StudentOrganisationForAerospaceResearch/Andromeda-V2.2/AndromedaV2.2.kicad_pcb

## KiCad design AndromedaV2.2.kicad_pcb (2019-05-11)

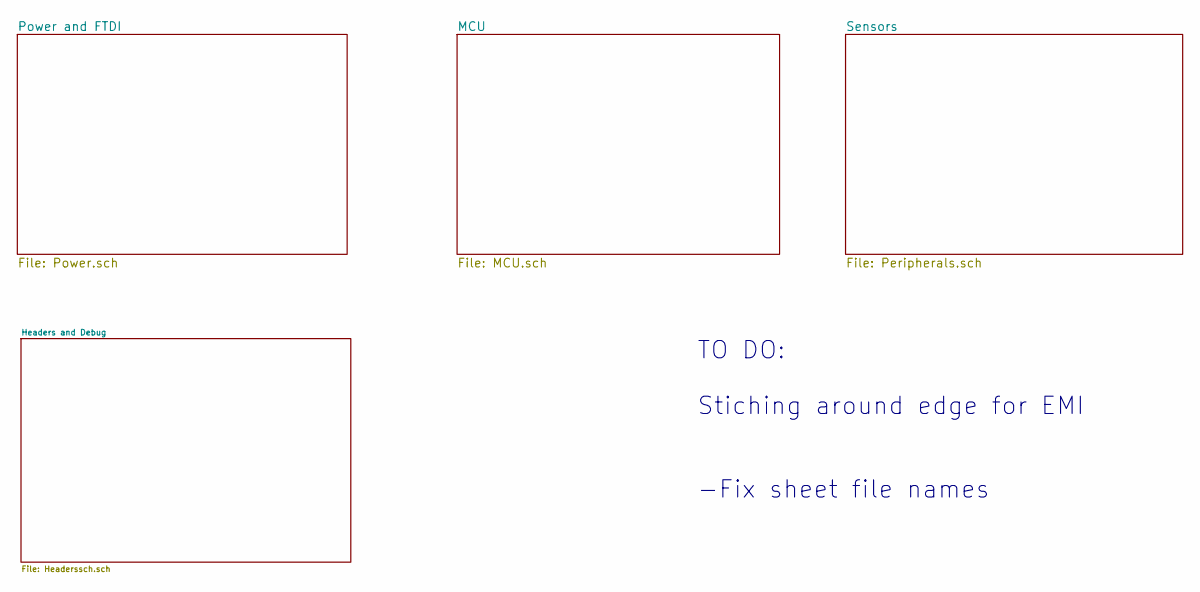
[picture p6: schematic AndromedaV2.2.sch, SOAR Avionics Sensor Board]

Notes on the sheet:
TO DO: Stiching around edge for EMI -Fix sheet file names

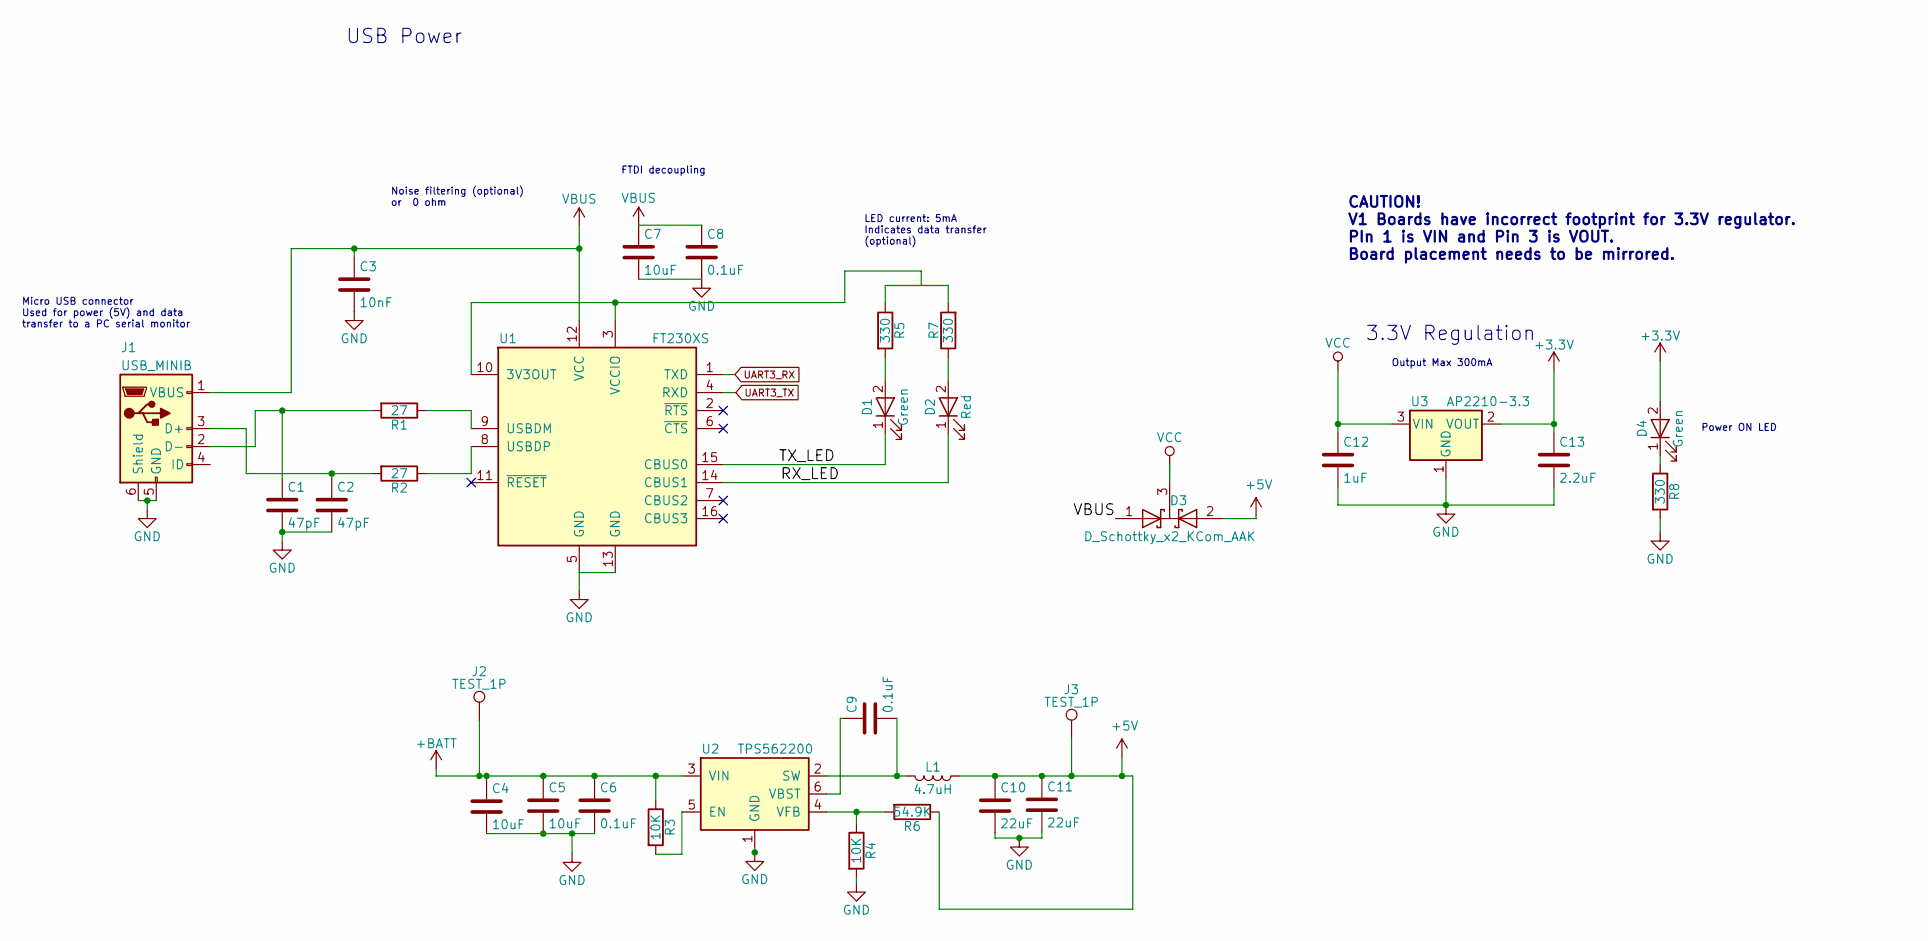
[picture p7: schematic Power.sch, SOAR Avionics Sensor Board]

Parts:
C1, C2: 47pF; C_0603
C3: 10nF; C_0603
C4, C5, C7: 10uF; C_0603
C6, C8, C9: 0.1uF; C_0603
C10, C11: 22uF; C_0603
C12: 1uF; C_0603
C13: 2.2uF; C_0603
D1, D4: Green; LED_0805_2012Metric; Digikey LG R971-KN-1
D2: Red; LED_0805_2012Metric; Digikey 475-1278-1-ND
D3: D_Schottky_x2_KCom_AAK; SOT-23; Digikey 1727-5188-1-ND
J1: USB_MINIB; USB-Mini-B; Digikey 690-005-299-043
J2, J3: TEST_1P; Test_Point_Pad_d1.5mm
L1: 4.7uH; L_1008
R1, R2: 27; R_0603
R3, R4: 10K; R_0603
R5, R7, R8: 330; R_0603
R6: 54.9K; R_0603
U1: FT230XS; SSOP-16_3.9x4.9mm_P0.635mm; Digikey 768-1135-1-ND
U2: TPS562200; SOT-23-6
U3: AP2210-3.3; SOT-23

Connections:
+3V3: C13.1, D4.2 (A), U3.2 (VOUT); also elsewhere on the board
+5V: C10.1, C11.1, D3.2 (A), J3.1, L1.1, R6.1; also elsewhere on the board
+BATT: C4.1, C5.1, C6.1, J2.1, R3.1, U2.3 (VIN); also elsewhere on the board
/Power and FTDI/RX_LED: D2.1 (K), U1.14 (CBUS1)
/Power and FTDI/TX_LED: D1.1 (K), U1.15 (CBUS0)
GND: C1.2, C2.2, C3.2, C4.2, C5.2, C6.2, C7.2, C8.2, C10.2, C11.2, C12.2, C13.2, J1.5 (GND), J1.6 (Shield), R4.2, R8.2, U1.5 (GND), U1.13 (GND), U2.1 (GND), U3.1 (GND); also elsewhere on the board
unnamed: C1.1, J1.2 (D-), R1.2
unnamed: C2.1, J1.3 (D+), R2.2
unnamed: C9.1, U2.6 (VBST)
unnamed: C9.2, L1.2, U2.2 (SW)
unnamed: D1.2 (A), R5.2
unnamed: D2.2 (A), R7.1
unnamed: D4.1 (K), R8.1
unnamed: R1.1, U1.9 (USBDM)
unnamed: R2.1, U1.8 (USBDP)
unnamed: R3.2, U2.5 (EN)
unnamed: R4.1, R6.2, U2.4 (VFB)
unnamed: R5.1, R7.2
unnamed: U1.3 (VCCIO), U1.10 (3V3OUT)
UART3_RX: U1.1 (TXD); also elsewhere on the board
UART3_TX: U1.4 (RXD); also elsewhere on the board
VBUS: C3.1, C7.1, C8.1, D3.1 (A), J1.1 (VBUS), U1.12 (VCC)
VCC: C12.1, D3.3 (K), U3.3 (VIN)

Notes on the sheet:
Output Max 300mA
Power ON LED
LED current: 5mA Indicates data transfer (optional)
Micro USB connector Used for power (5V) and data transfer to a PC serial monitor
Noise filtering (optional) or 0 ohm
FTDI decoupling
USB Power
3.3V Regulation
CAUTION! V1 Boards have incorrect footprint for 3.3V regulator. PIn 1 is VIN and Pin 3 is VOUT. Board placement needs to be mirrored.

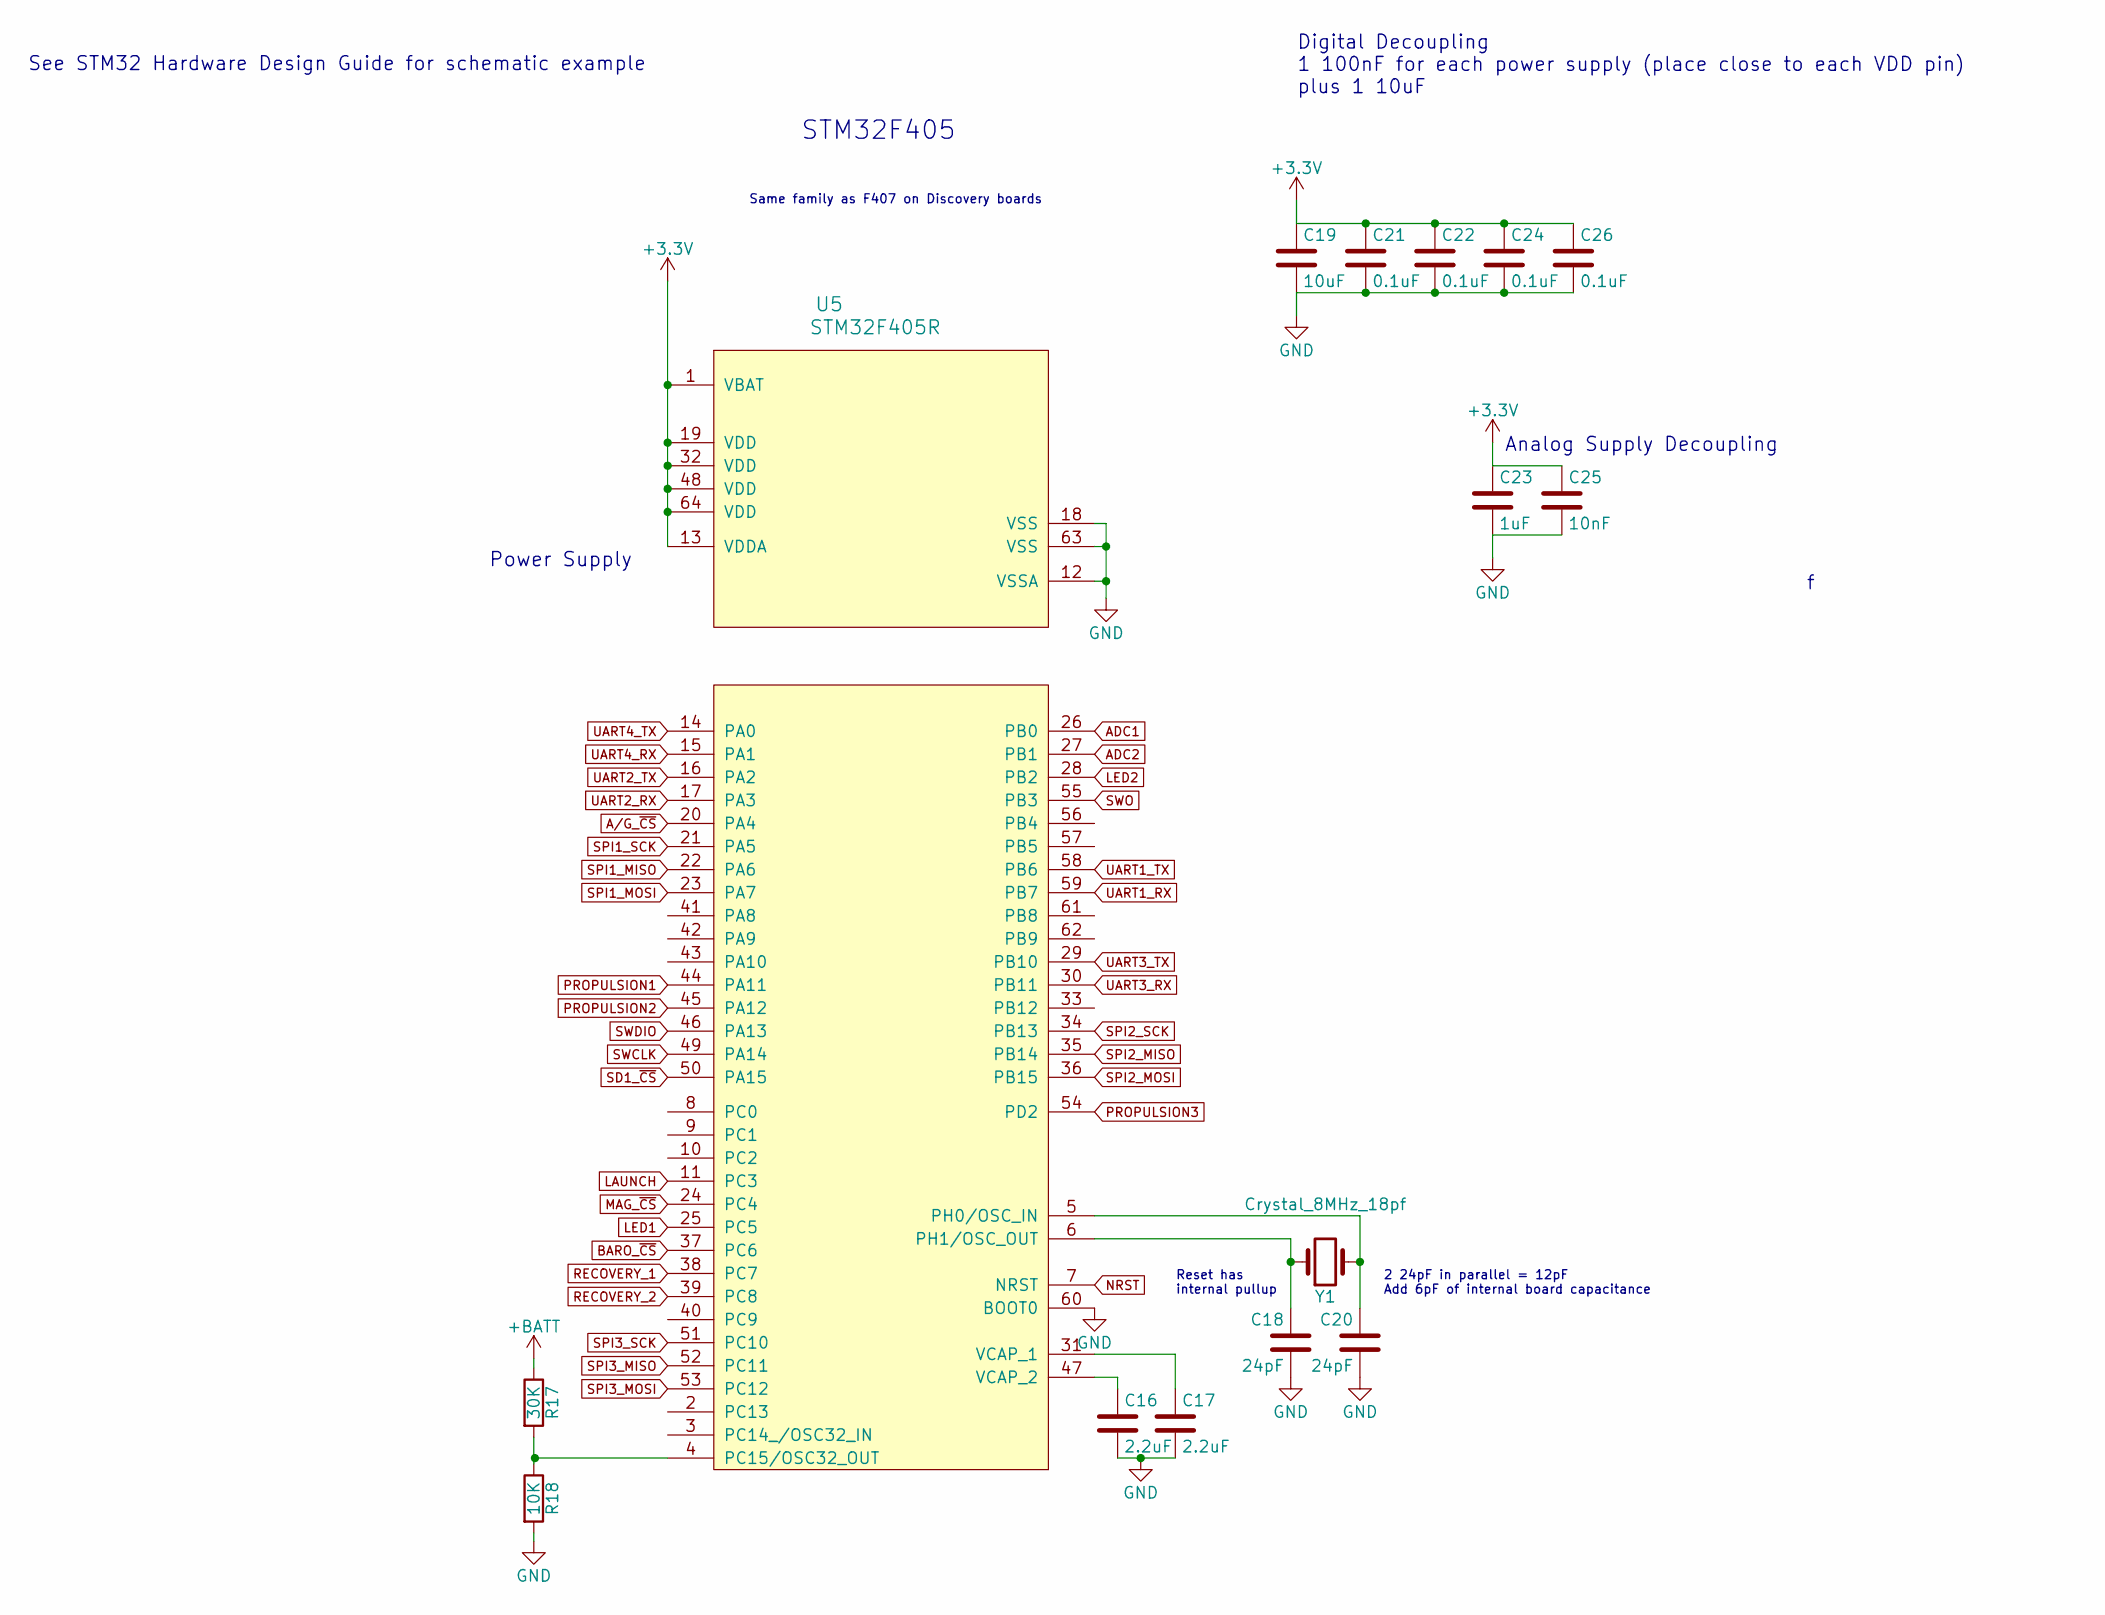
[picture p8: schematic MCU.sch, SOAR Avionics Sensor Board]

Parts:
C16, C17: 2.2uF; C_0603
C18, C20: 24pF; C_0603
C19: 10uF; C_0603
C21, C22, C24, C26: 0.1uF; C_0603
C23: 1uF; C_0603
C25: 10nF; C_0603
R17: 30K; R_0603
R18: 10K; R_0603
U5: STM32F405R; LQFP-64_10x10mm_P0.5mm; Digikey 497-11767-ND
Y1: Crystal_8MHz_18pf; Crystal_SMD_HC49-SD; Digikey 535-9089-1-ND

Connections:
+3V3: C19.1, C21.1, C22.1, C23.1, C24.1, C25.1, C26.1, U5.1 (VBAT), U5.13 (VDDA), U5.19 (VDD), U5.32 (VDD), U5.48 (VDD), U5.64 (VDD); also elsewhere on the board
+BATT: R17.1; also elsewhere on the board
A/G_~CS: U5.20 (PA4); also elsewhere on the board
ADC1: U5.26 (PB0); also elsewhere on the board
ADC2: U5.27 (PB1); also elsewhere on the board
BARO_~CS: U5.37 (PC6); also elsewhere on the board
GND: C16.2, C17.2, C18.2, C19.2, C20.2, C21.2, C22.2, C23.2, C24.2, C25.2, C26.2, R18.2, U5.12 (VSSA), U5.18 (VSS), U5.60 (BOOT0), U5.63 (VSS); also elsewhere on the board
LAUNCH: U5.11 (PC3); also elsewhere on the board
LED1: U5.25 (PC5); also elsewhere on the board
LED2: U5.28 (PB2); also elsewhere on the board
MAG_~CS: U5.24 (PC4); also elsewhere on the board
NRST: U5.7 (NRST); also elsewhere on the board
unnamed: C16.1, U5.47 (VCAP_2)
unnamed: C17.1, U5.31 (VCAP_1)
unnamed: C18.1, U5.6 (PH1/OSC_OUT), Y1.1
unnamed: C20.1, U5.5 (PH0/OSC_IN), Y1.2
unnamed: R17.2, R18.1, U5.4 (PC15/OSC32_OUT)
PROPULSION1: U5.44 (PA11); also elsewhere on the board
PROPULSION2: U5.45 (PA12); also elsewhere on the board
PROPULSION3: U5.54 (PD2); also elsewhere on the board
RECOVERY_1: U5.38 (PC7); also elsewhere on the board
RECOVERY_2: U5.39 (PC8); also elsewhere on the board
SD1_~CS: U5.50 (PA15); also elsewhere on the board
SPI1_MISO: U5.22 (PA6); also elsewhere on the board
SPI1_MOSI: U5.23 (PA7); also elsewhere on the board
SPI1_SCK: U5.21 (PA5); also elsewhere on the board
SPI2_MISO: U5.35 (PB14); also elsewhere on the board
SPI2_MOSI: U5.36 (PB15); also elsewhere on the board
SPI2_SCK: U5.34 (PB13); also elsewhere on the board
SPI3_MISO: U5.52 (PC11); also elsewhere on the board
SPI3_MOSI: U5.53 (PC12); also elsewhere on the board
SPI3_SCK: U5.51 (PC10); also elsewhere on the board
SWCLK: U5.49 (PA14); also elsewhere on the board
SWDIO: U5.46 (PA13); also elsewhere on the board
SWO: U5.55 (PB3); also elsewhere on the board
UART1_RX: U5.59 (PB7); also elsewhere on the board
UART1_TX: U5.58 (PB6); also elsewhere on the board
UART2_RX: U5.17 (PA3); also elsewhere on the board
UART2_TX: U5.16 (PA2); also elsewhere on the board
UART3_RX: U5.30 (PB11); also elsewhere on the board
UART3_TX: U5.29 (PB10); also elsewhere on the board
UART4_RX: U5.15 (PA1); also elsewhere on the board
UART4_TX: U5.14 (PA0); also elsewhere on the board

Notes on the sheet:
Reset has internal pullup
Digital Decoupling 1 100nF for each power supply (place close to each VDD pin) plus 1 10uF
Analog Supply Decoupling
See STM32 Hardware Design Guide for schematic example
Power Supply
2 24pF in parallel = 12pF Add 6pF of internal board capacitance
STM32F405
Same family as F407 on Discovery boards

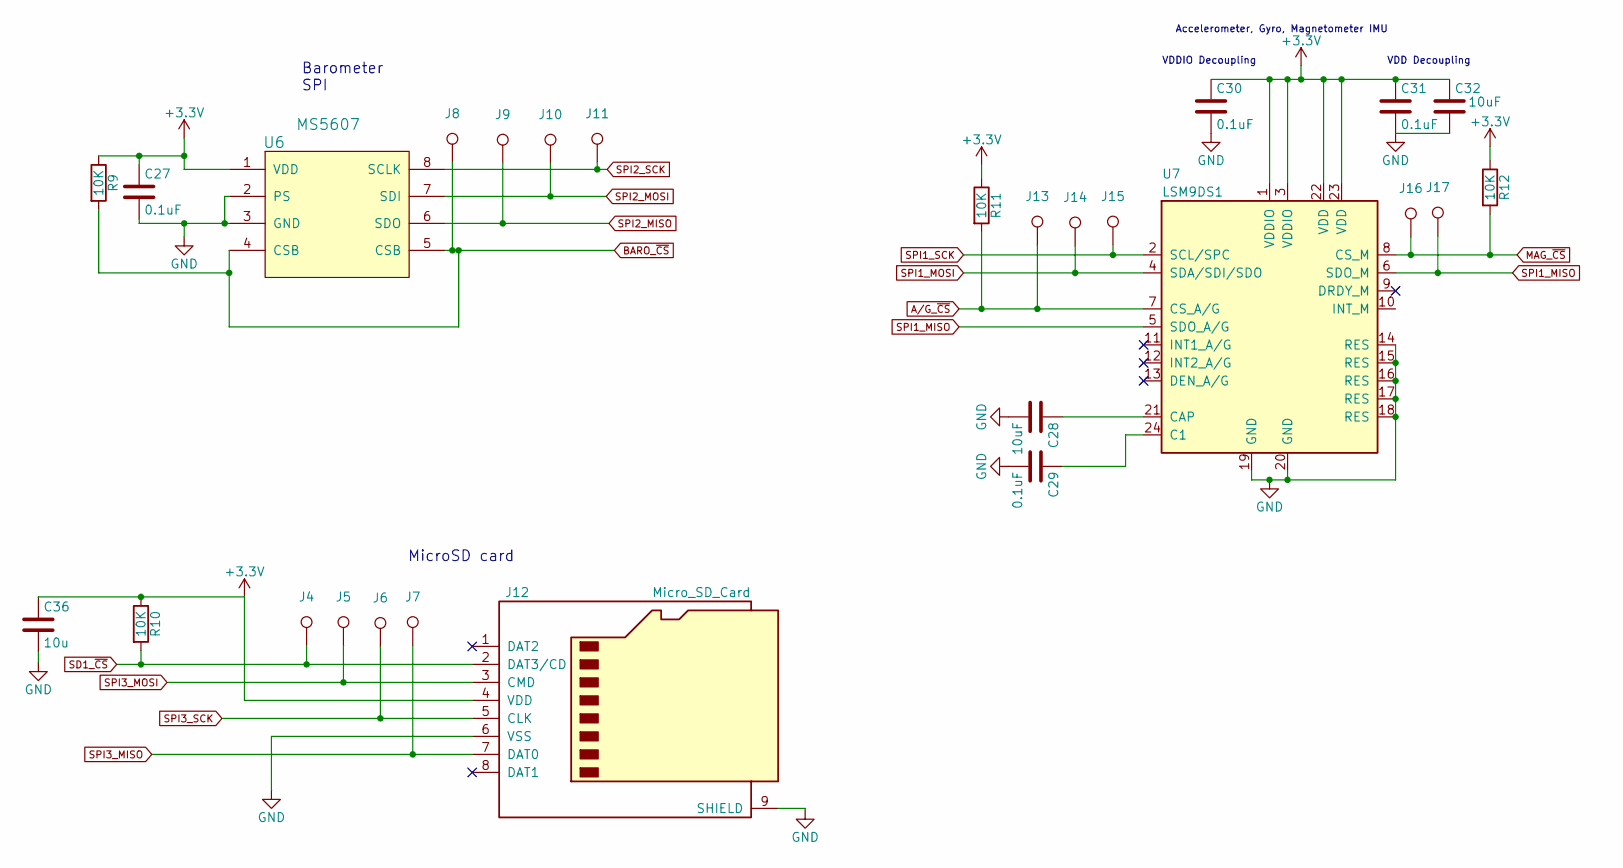
[picture p9: schematic Peripherals.sch, SOAR Avionics Sensor Board]

Parts:
C27, C29, C30, C31: 0.1uF; C_0603
C28, C32: 10uF; C_0603
C36: 10u; C_0603
J4, J5, J6, J7, J8, J9, J10, J11, J13, J14, J15, J16, J17: TEST_1P; Test_Point_Pad_d1.5mm
J12: Micro_SD_Card; Hirose_DM3AT-SF-PEJM5_MicroSD; Digikey 0472192001
R9, R10, R11, R12: 10K; R_0603
U6: MS5607; LGA-8_3x5mm_P1.25mm; Digikey MS560702BA03-00
U7: LSM9DS1; LGA-24L_3x3.5mm_P0.43mm; Digikey 497-14946-1-ND

Connections:
+3V3: C27.1, C30.1, C31.1, C32.1, C36.1, J12.4 (VDD), R9.1, R10.1, R11.1, R12.1, U6.1 (VDD), U7.1 (VDDIO), U7.3 (VDDIO), U7.22 (VDD), U7.23 (VDD); also elsewhere on the board
A/G_~CS: J13.1, R11.2, U7.7 (CS_A/G); also elsewhere on the board
BARO_~CS: J8.1, R9.2, U6.4 (CSB), U6.5 (CSB); also elsewhere on the board
GND: C27.2, C28.2, C29.2, C30.2, C31.2, C32.2, C36.2, J12.6 (VSS), J12.9 (SHIELD), U6.2 (PS), U6.3 (GND), U7.14 (RES), U7.15 (RES), U7.16 (RES), U7.17 (RES), U7.18 (RES), U7.19 (GND), U7.20 (GND); also elsewhere on the board
MAG_~CS: J16.1, R12.2, U7.8 (CS_M); also elsewhere on the board
unnamed: C28.1, U7.21 (CAP)
unnamed: C29.1, U7.24 (C1)
SD1_~CS: J4.1, J12.2 (DAT3/CD), R10.2; also elsewhere on the board
SPI1_MISO: J17.1, U7.5 (SDO_A/G), U7.6 (SDO_M); also elsewhere on the board
SPI1_MOSI: J14.1, U7.4 (SDA/SDI/SDO); also elsewhere on the board
SPI1_SCK: J15.1, U7.2 (SCL/SPC); also elsewhere on the board
SPI2_MISO: J9.1, U6.6 (SDO); also elsewhere on the board
SPI2_MOSI: J10.1, U6.7 (SDI); also elsewhere on the board
SPI2_SCK: J11.1, U6.8 (SCLK); also elsewhere on the board
SPI3_MISO: J7.1, J12.7 (DAT0); also elsewhere on the board
SPI3_MOSI: J5.1, J12.3 (CMD); also elsewhere on the board
SPI3_SCK: J6.1, J12.5 (CLK); also elsewhere on the board

Notes on the sheet:
Barometer SPI
VDD Decoupling
VDDIO Decoupling
MicroSD card
Accelerometer, Gyro, Magnetometer IMU

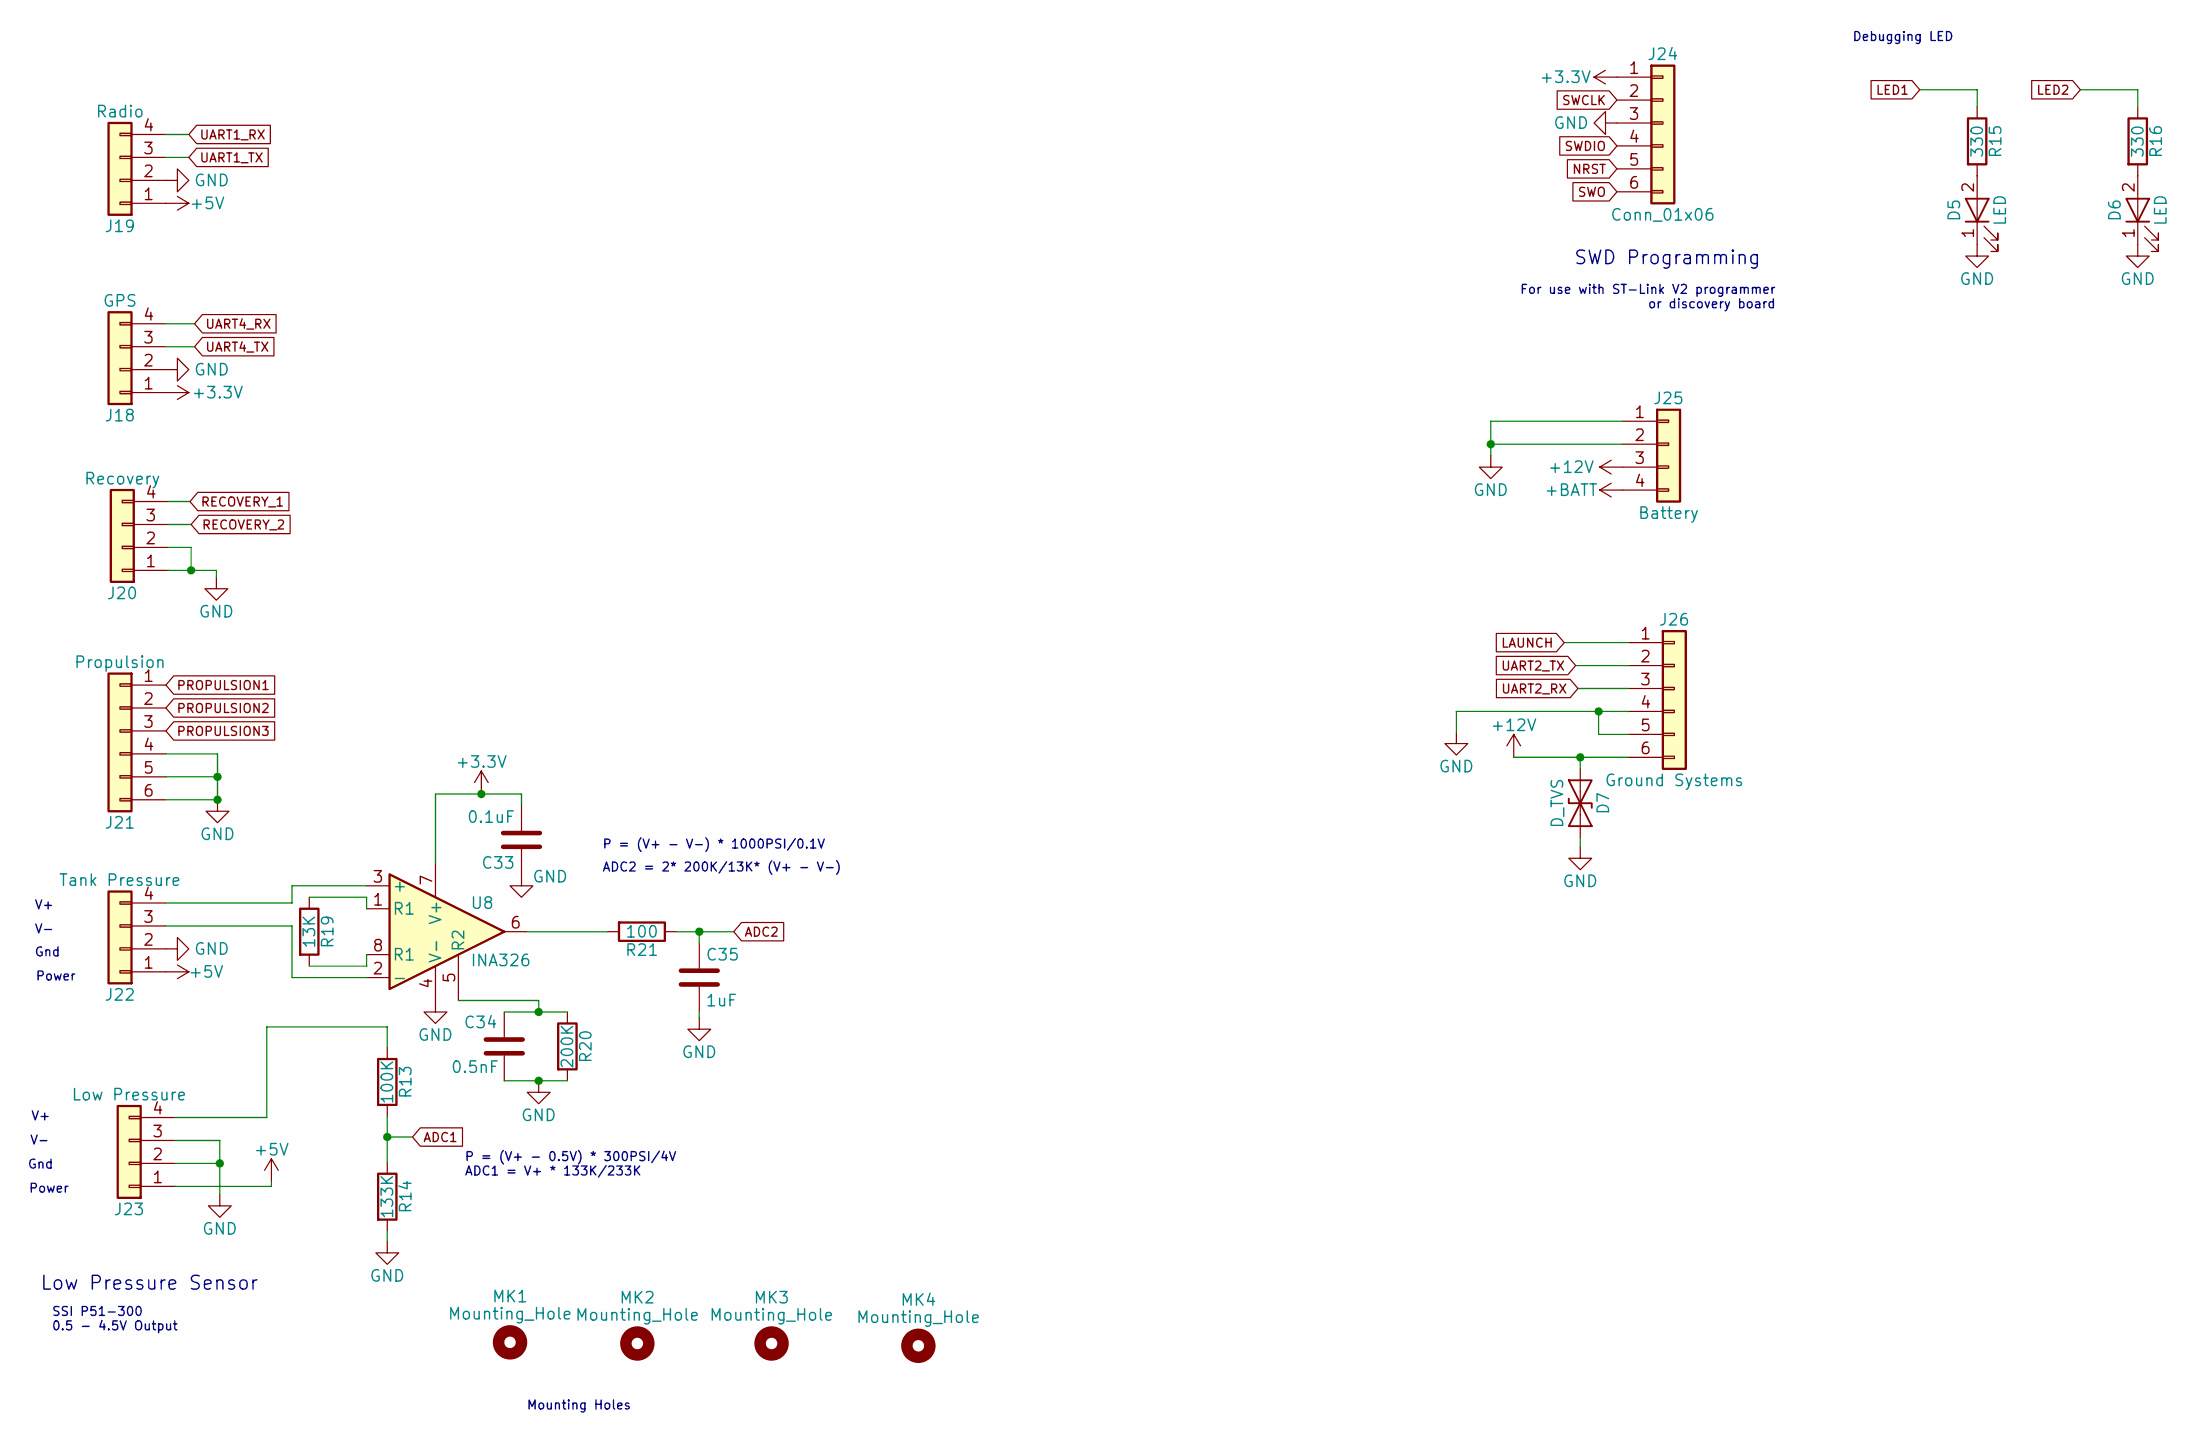
[picture p10: schematic Headerssch.sch, SOAR Avionics Sensor Board]

Parts:
C33: 0.1uF; C_0603
C34: 0.5nF; C_0603
C35: 1uF; C_0603
D5, D6: LED; LED_0805_2012Metric
D7: D_TVS; D_SOD-323
J18: GPS; Molex_Micro-Fit_3.0_43045-0400_2x02_P3.00mm_Horizontal
J19: Radio; Molex_Micro-Fit_3.0_43045-0400_2x02_P3.00mm_Horizontal
J20: Recovery; Molex_Micro-Fit_3.0_43045-0400_2x02_P3.00mm_Horizontal
J21: Propulsion; Molex_Micro-Fit_3.0_43045-0600_2x03_P3.00mm_Horizontal
J22: Tank Pressure; Molex_Micro-Fit_3.0_43045-0400_2x02_P3.00mm_Horizontal
J23: Low Pressure; Molex_Micro-Fit_3.0_43045-0400_2x02_P3.00mm_Horizontal
J24: Conn_01x06; PinHeader_1x06_P2.54mm_Vertical
J25: Battery; Molex_Micro-Fit_3.0_43045-0400_2x02_P3.00mm_Horizontal
J26: Ground Systems; Molex_Micro-Fit_3.0_43045-0600_2x03_P3.00mm_Horizontal
MK1, MK2, MK3, MK4: Mounting_Hole; MountingHole_2.5mm_Pad
R13: 100K; R_0603
R14: 133K; R_0603
R15, R16: 330; R_0603
R19: 13K; R_0603
R20: 200K; R_0603
R21: 100; R_0603
U8: INA326; MSOP-8_3x3mm_Pitch0.65mm

Connections:
+3V3: C33.2, J18.1, J24.1, U8.7 (V+); also elsewhere on the board
+5V: J19.1, J22.1, J23.1; also elsewhere on the board
+12V: D7.1 (A1), J25.3, J26.6
+BATT: J25.4; also elsewhere on the board
ADC1: R13.2, R14.1; also elsewhere on the board
ADC2: C35.1, R21.1; also elsewhere on the board
GND: C33.1, C34.2, C35.2, D5.1 (K), D6.1 (K), D7.2 (A2), J18.2, J19.2, J20.1, J20.2, J21.4, J21.5, J21.6, J22.2, J23.2, J23.3, J24.3, J25.1, J25.2, J26.4, J26.5, R14.2, R20.2, U8.4 (V-); also elsewhere on the board
LAUNCH: J26.1; also elsewhere on the board
LED1: R15.1; also elsewhere on the board
LED2: R16.1; also elsewhere on the board
NRST: J24.5; also elsewhere on the board
unnamed: C34.1, R20.1, U8.5 (R2)
unnamed: D5.2 (A), R15.2
unnamed: D6.2 (A), R16.2
unnamed: J22.3, U8.2 (-)
unnamed: J22.4, U8.3 (+)
unnamed: J23.4, R13.1
unnamed: R19.1, U8.1 (R1)
unnamed: R19.2, U8.8 (R1)
unnamed: R21.2, U8.6
PROPULSION1: J21.1; also elsewhere on the board
PROPULSION2: J21.2; also elsewhere on the board
PROPULSION3: J21.3; also elsewhere on the board
RECOVERY_1: J20.4; also elsewhere on the board
RECOVERY_2: J20.3; also elsewhere on the board
SWCLK: J24.2; also elsewhere on the board
SWDIO: J24.4; also elsewhere on the board
SWO: J24.6; also elsewhere on the board
UART1_RX: J19.4; also elsewhere on the board
UART1_TX: J19.3; also elsewhere on the board
UART2_RX: J26.3; also elsewhere on the board
UART2_TX: J26.2; also elsewhere on the board
UART4_RX: J18.4; also elsewhere on the board
UART4_TX: J18.3; also elsewhere on the board

Notes on the sheet:
SWD Programming
For use with ST-Link V2 programmer or discovery board
Debugging LED
Mounting Holes
Low Pressure Sensor
Power
Gnd
SSI P51-300 0.5 - 4.5V Output
P = (V+ - 0.5V) * 300PSI/4V ADC1 = V+ * 133K/233K
ADC2 = 2* 200K/13K* (V+ - V-)
P = (V+ - V-) * 1000PSI/0.1V

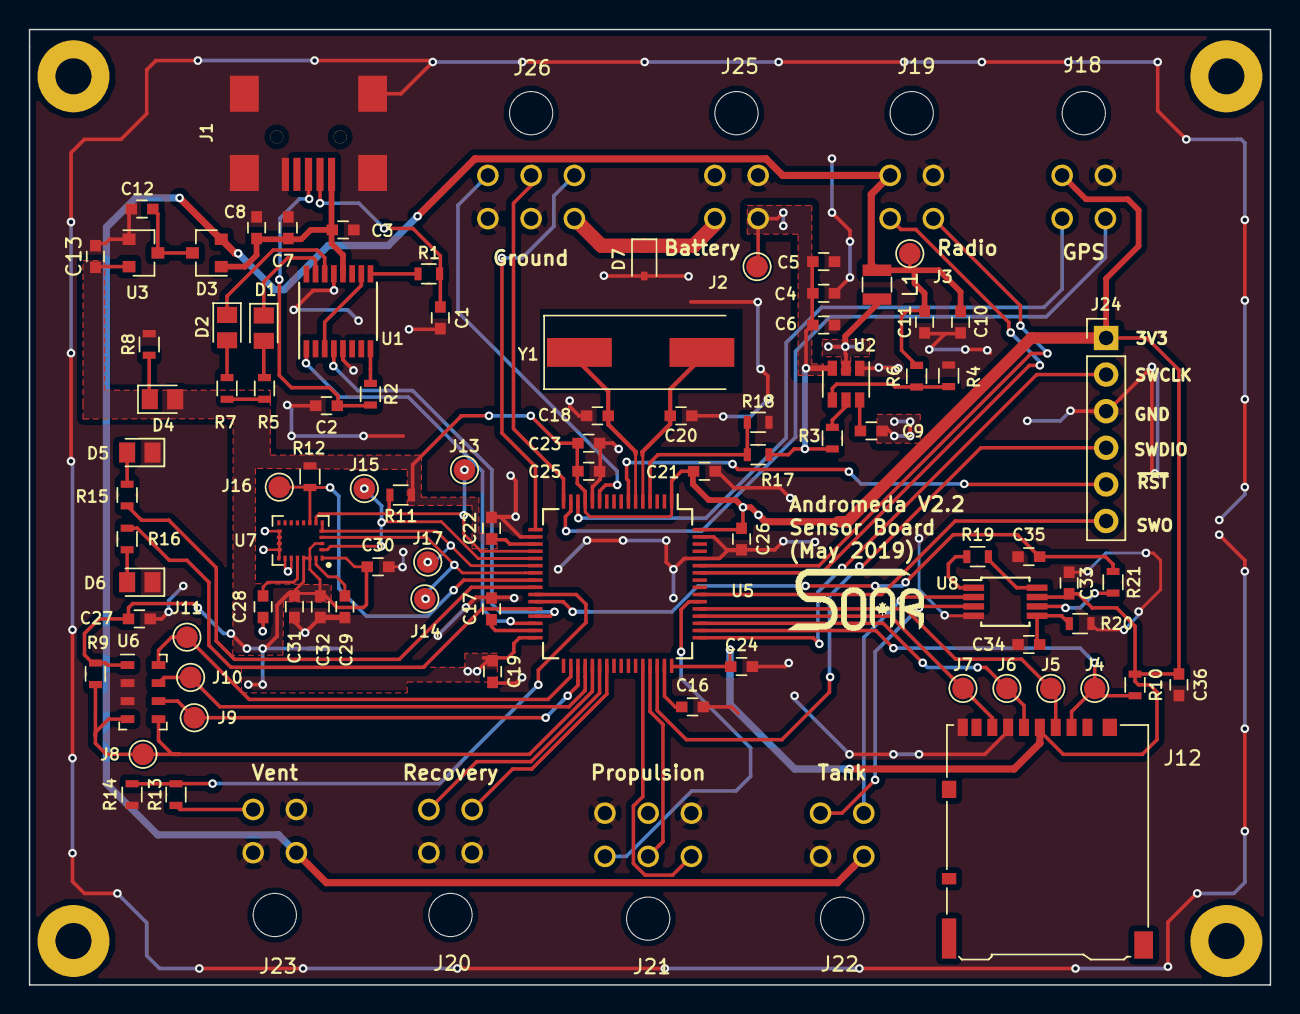
[picture p11: board AndromedaV2.2.kicad_pcb from above]

Board: 2 copper layers, 86.1 x 66.3 mm, 102 parts (0 on the bottom side), 73 nets.

Other parts of the board:
LOGO_SOAR: LOGO_SOAR
